gauravshilpakar/HoolakiBot/Code/readme.md

1. Constraints: File for the BASYS 3 Board.
2. Design Source: All required for the project. 
3. Simulation: Motor Simulation Tests.
