gauravshilpakar/HoolakiBot/Circuits/readme.md

Voltage Regulator for Metal Detecting IPS
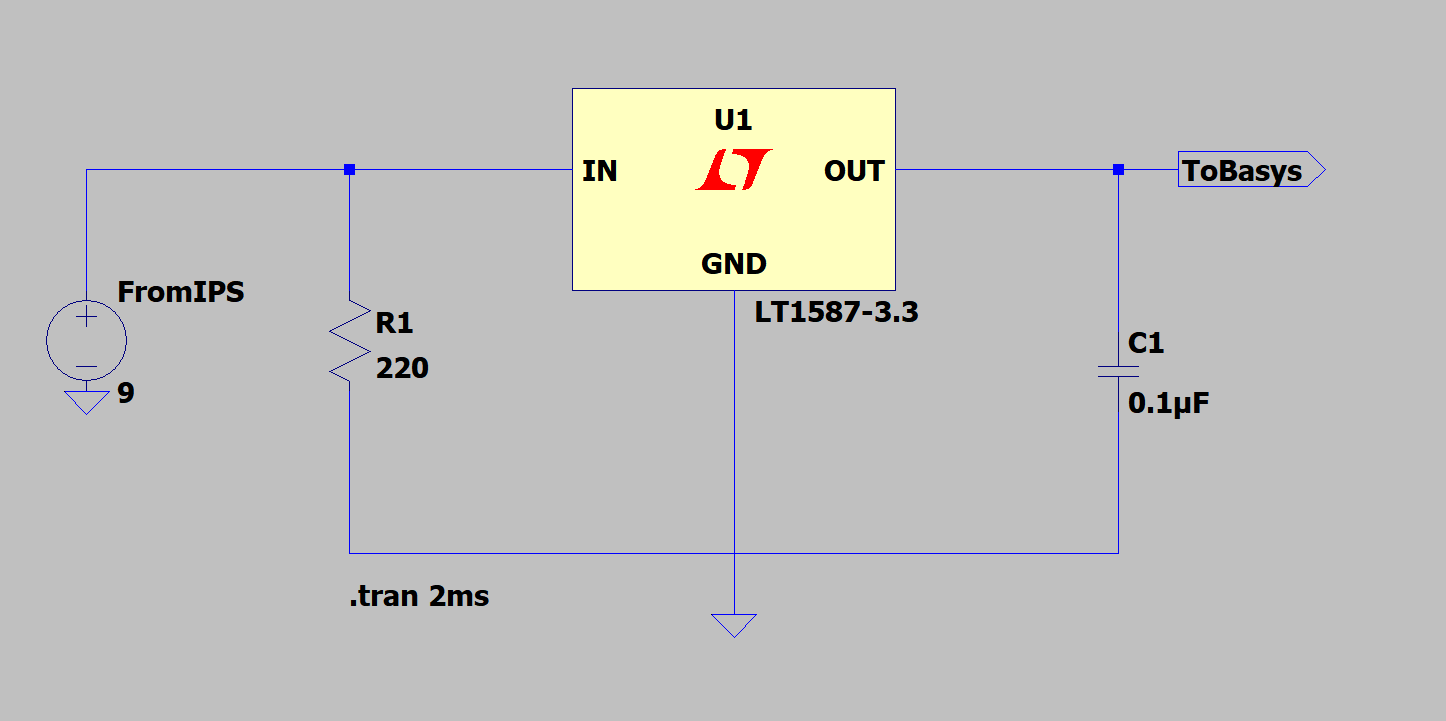
[picture p1: Circuits/l78l33.PNG]
