gauravshilpakar/HoolakiBot/Green Board/readme.md

PCB Design Used the circuit as given:
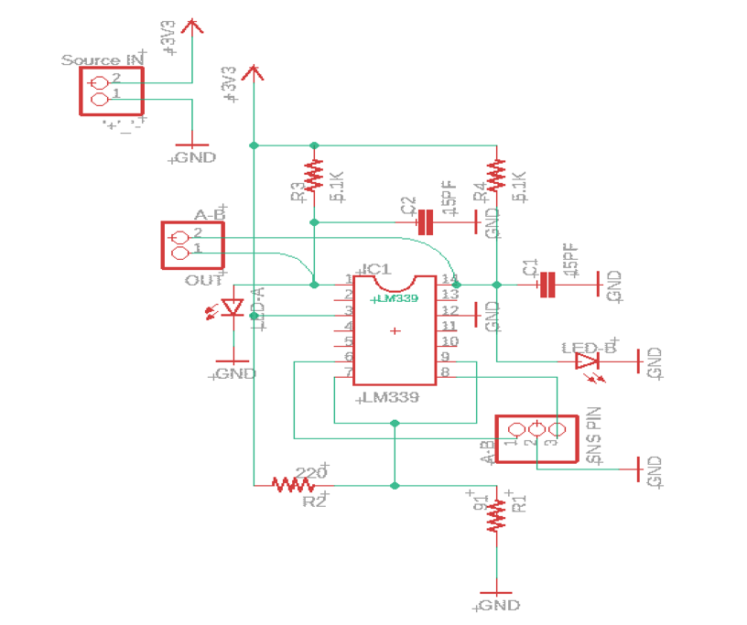
[picture p2: Green Board/Schematic.png]
