gauravshilpakar/HoolakiBot/Circuits/lm317.PNG

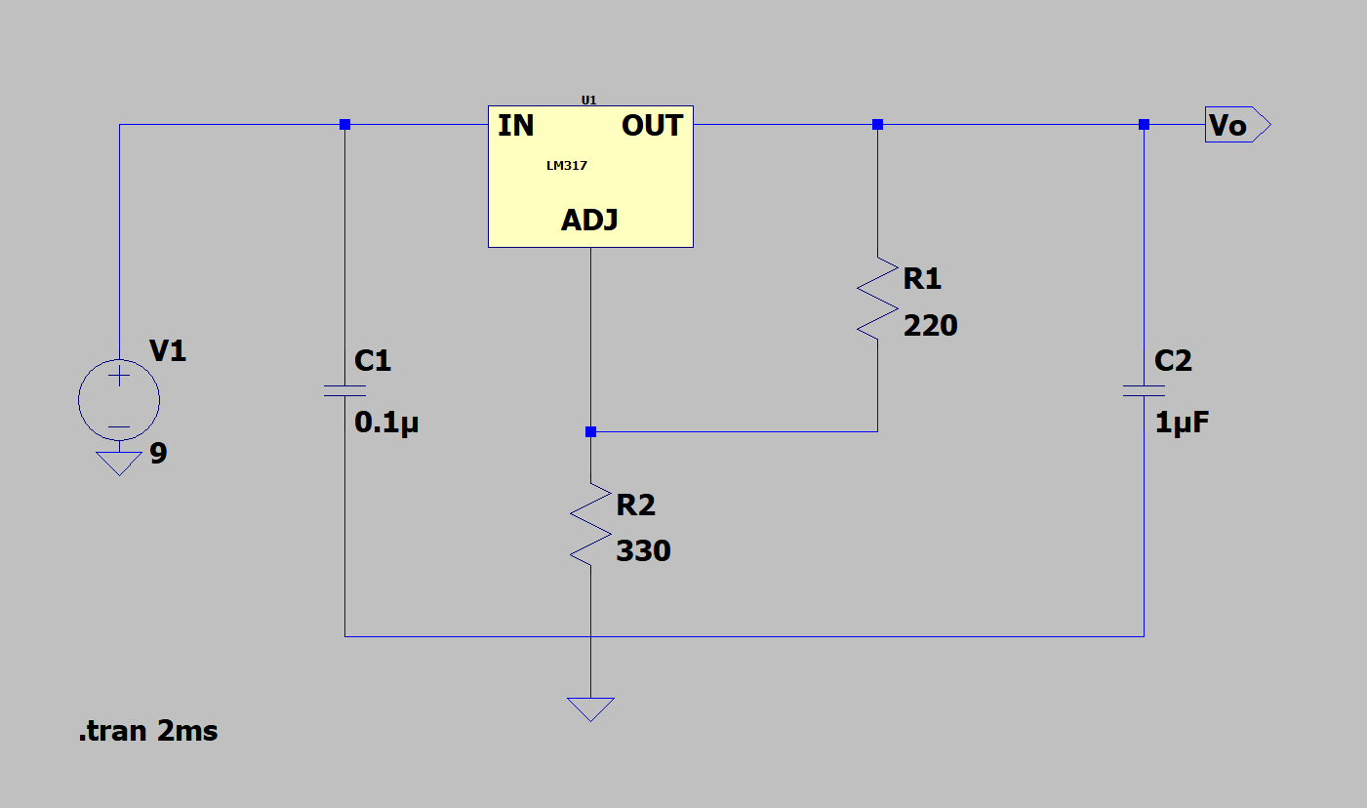
Circuits/lm317.PNG
