gauravshilpakar/HoolakiBot/Circuits/lm324_TEKT IR Circuit.PNG

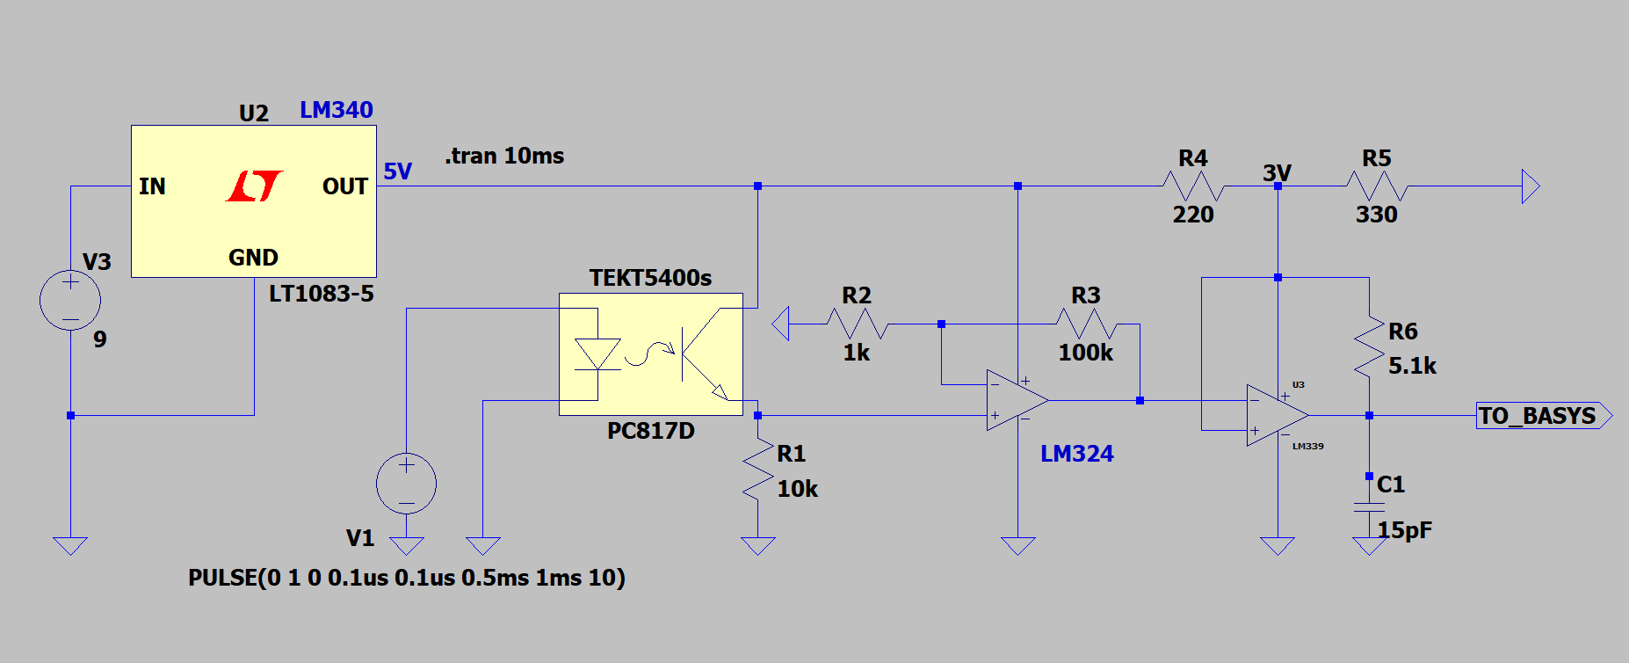
Circuits/lm324_TEKT IR Circuit.PNG
