gauravshilpakar/HoolakiBot/Circuits/lm339 current protection circuit.PNG

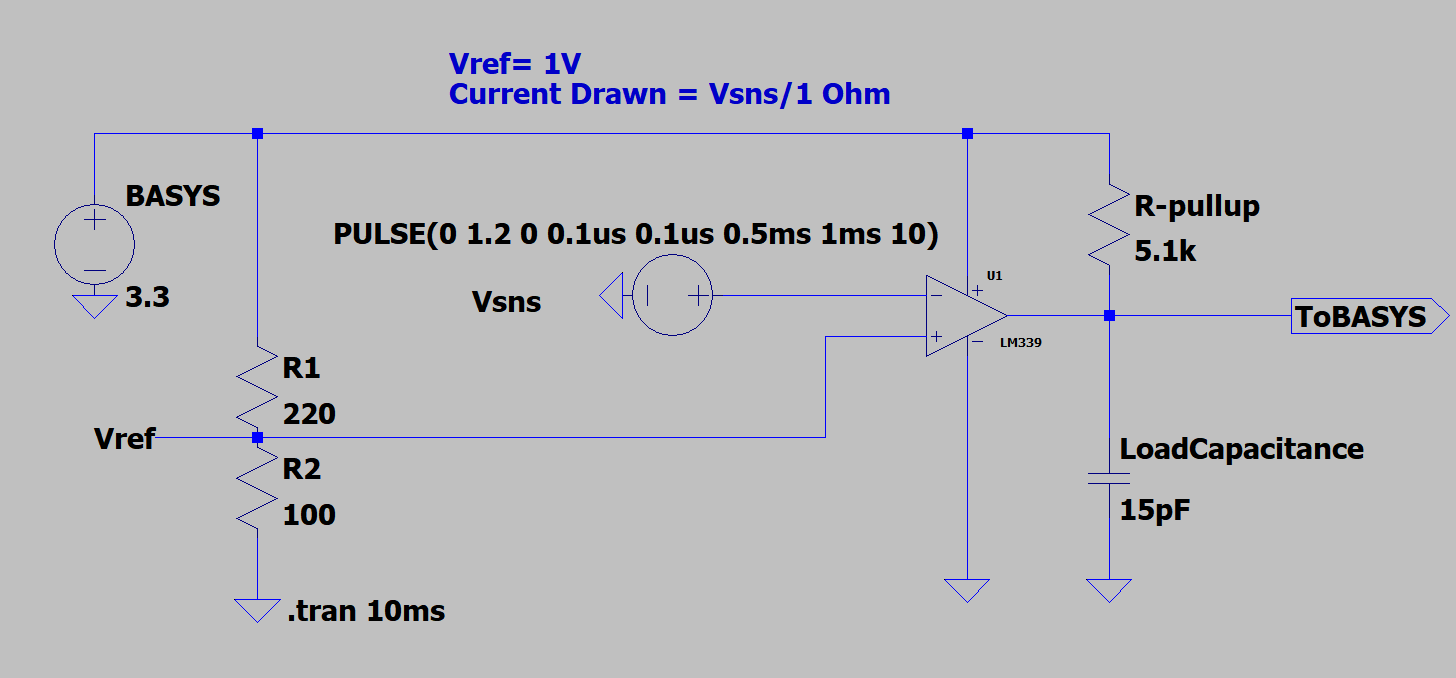
Circuits/lm339 current protection circuit.PNG
