gauravshilpakar/HoolakiBot/Circuits/lm555.PNG

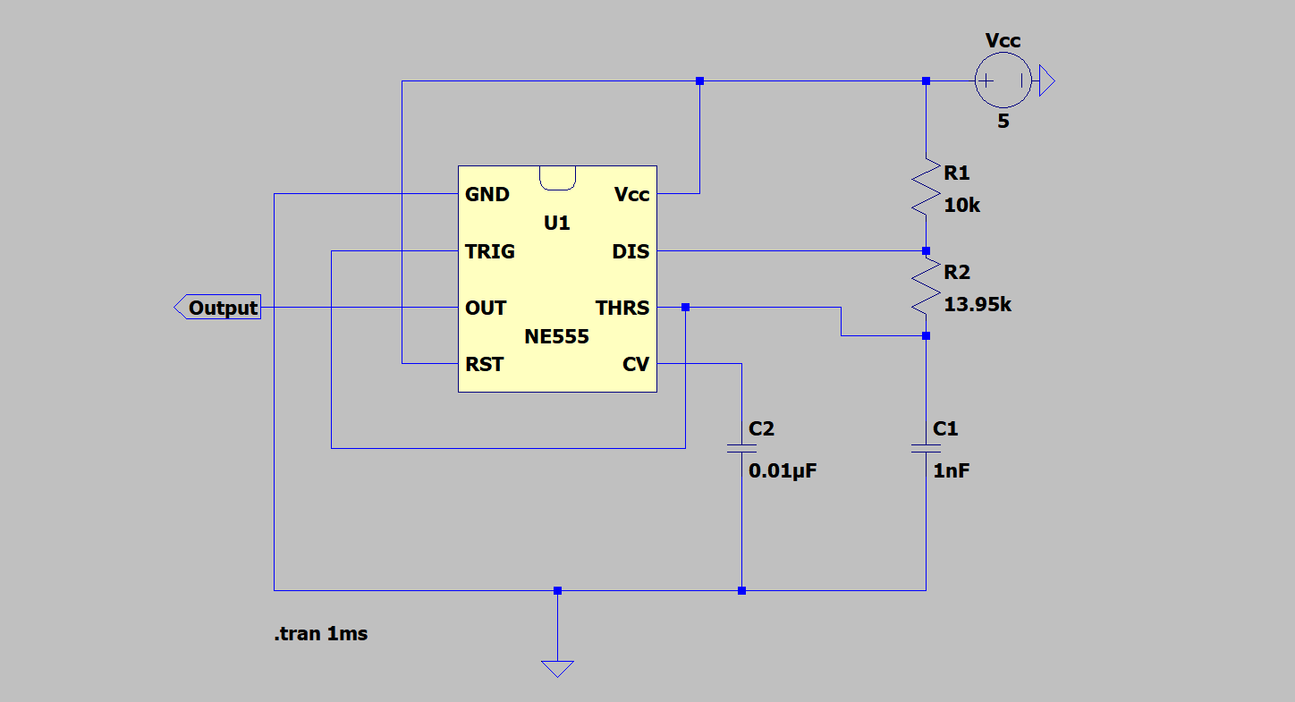
Circuits/lm555.PNG
