gauravshilpakar/HoolakiBot/Green Board/Final_PCB.png

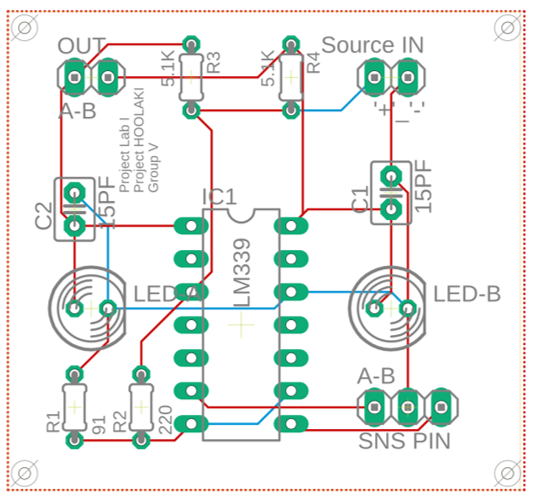
Green Board/Final_PCB.png
