gauravshilpakar/HoolakiBot/Green Board/Ratnested.png

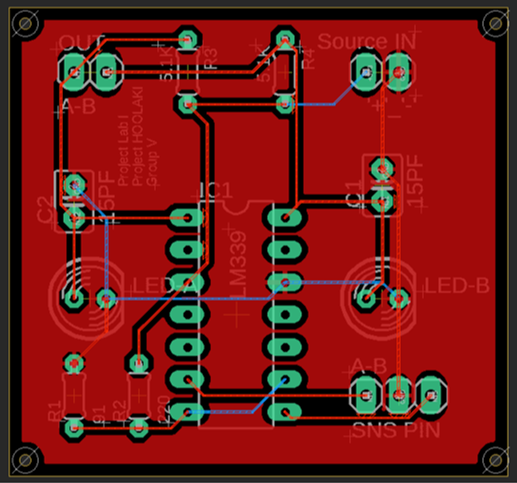
Green Board/Ratnested.png
