gauravshilpakar/HoolakiBot/Green Board/routedGB.png

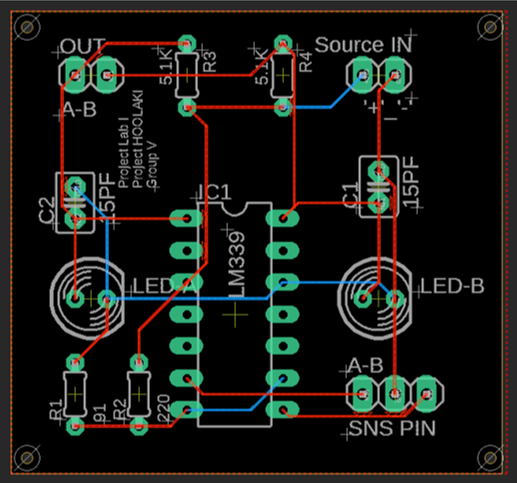
Green Board/routedGB.png
