gauravshilpakar/HoolakiBot/(commit log)

2019-10-26 edited circuits folder
2019-10-26 reedit circuits[C
